fellesverkstedet/1810-CNC-Addons/Enclosure/Readme

This folder contains construction drawings for an enclosure, which can contain the 1810-CNC.
