fellesverkstedet/1810-CNC-Addons/Enclosure/README.md

# 1810-CNC-Addons
Parts for improving the small CNC milling machines at Fellesverkstedet
