fellesverkstedet/1810-CNC-Addons/HomingExtensions/X_Y_Axis_SensorHolder.step

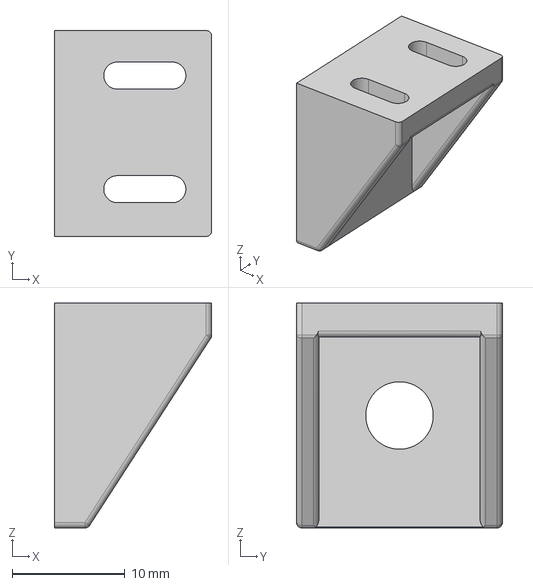
[picture p6: CAD file, 2019-10-28]
HomingExtensions/X_Y_Axis_SensorHolder.step
14.0 x 18.3 x 20.0 mm
