fellesverkstedet/1810-CNC-Addons/Maintenance/sacraficial-layer-for-1810-mill.dxf

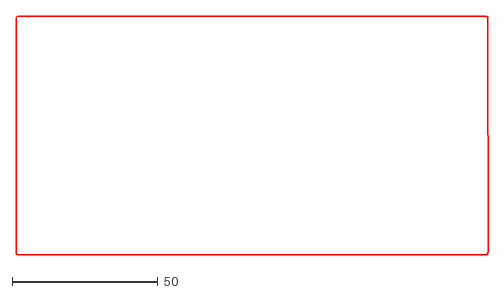
[picture p7: CAD file, 2021-08-19]
Maintenance/sacraficial-layer-for-1810-mill.dxf
162.0 x 82.0
