fellesverkstedet/1810-CNC-Addons/ControllerCase/ControllerCaseLower v11.step

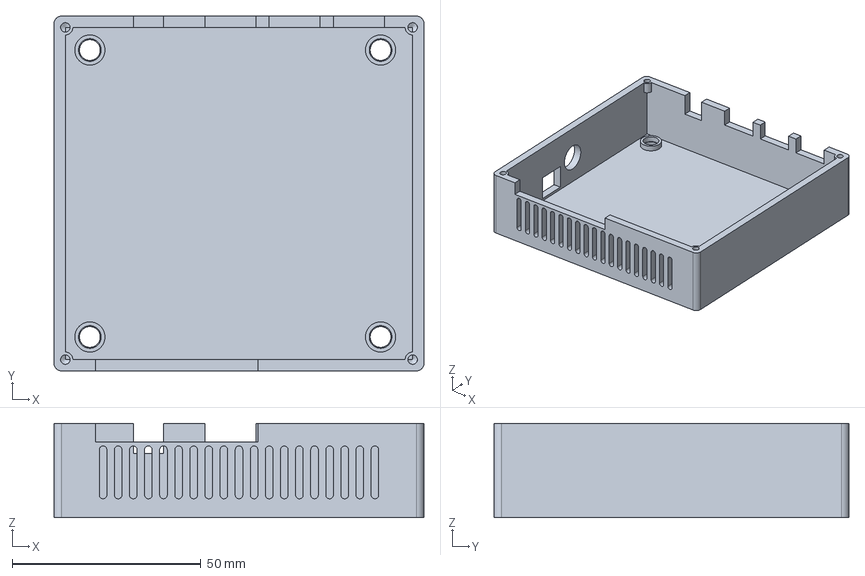
[picture p8: CAD file, 2019-10-28]
ControllerCase/ControllerCaseLower v11.step
98.0 x 94.0 x 25.0 mm
