fellesverkstedet/1810-CNC-Addons/HomingExtensions/X_Axis_SensorClipOn.step

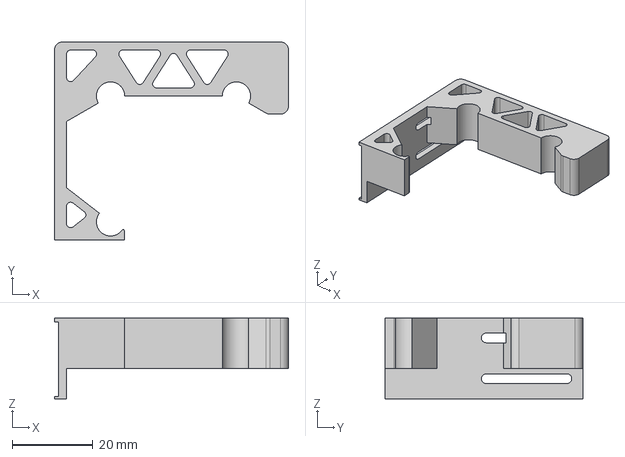
[picture p10: CAD file, 2019-10-28]
HomingExtensions/X_Axis_SensorClipOn.step
58.0 x 49.1 x 20.0 mm
