fellesverkstedet/1810-CNC-Addons/ControllerCase/CaseLid v4.step

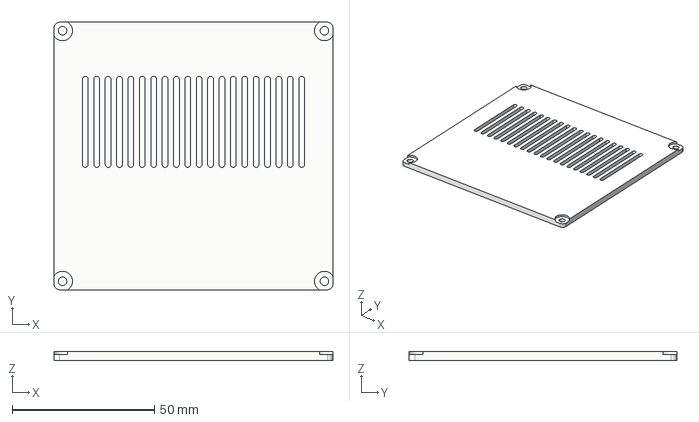
[picture p11: CAD file, 2019-10-28]
ControllerCase/CaseLid v4.step
98.0 x 94.0 x 3.00 mm
