fellesverkstedet/1810-CNC-Addons/Enclosure/Sides v5.step

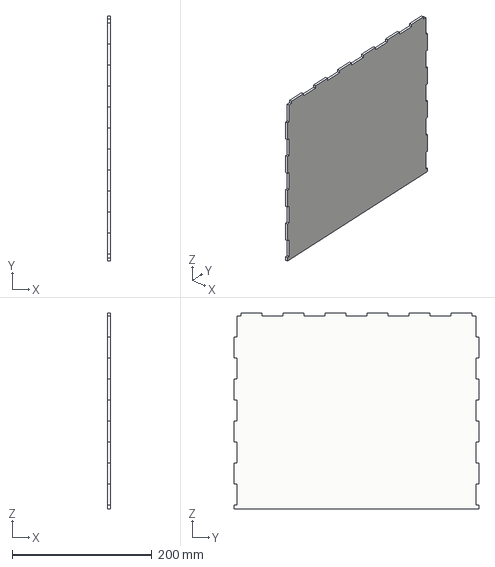
[picture p12: CAD file, 2019-10-28]
Enclosure/Sides v5.step
4.00 x 350.0 x 280.0 mm
