fellesverkstedet/1810-CNC-Addons/ControllerCase/CaseLid Drawing v1 Sheet1.dxf

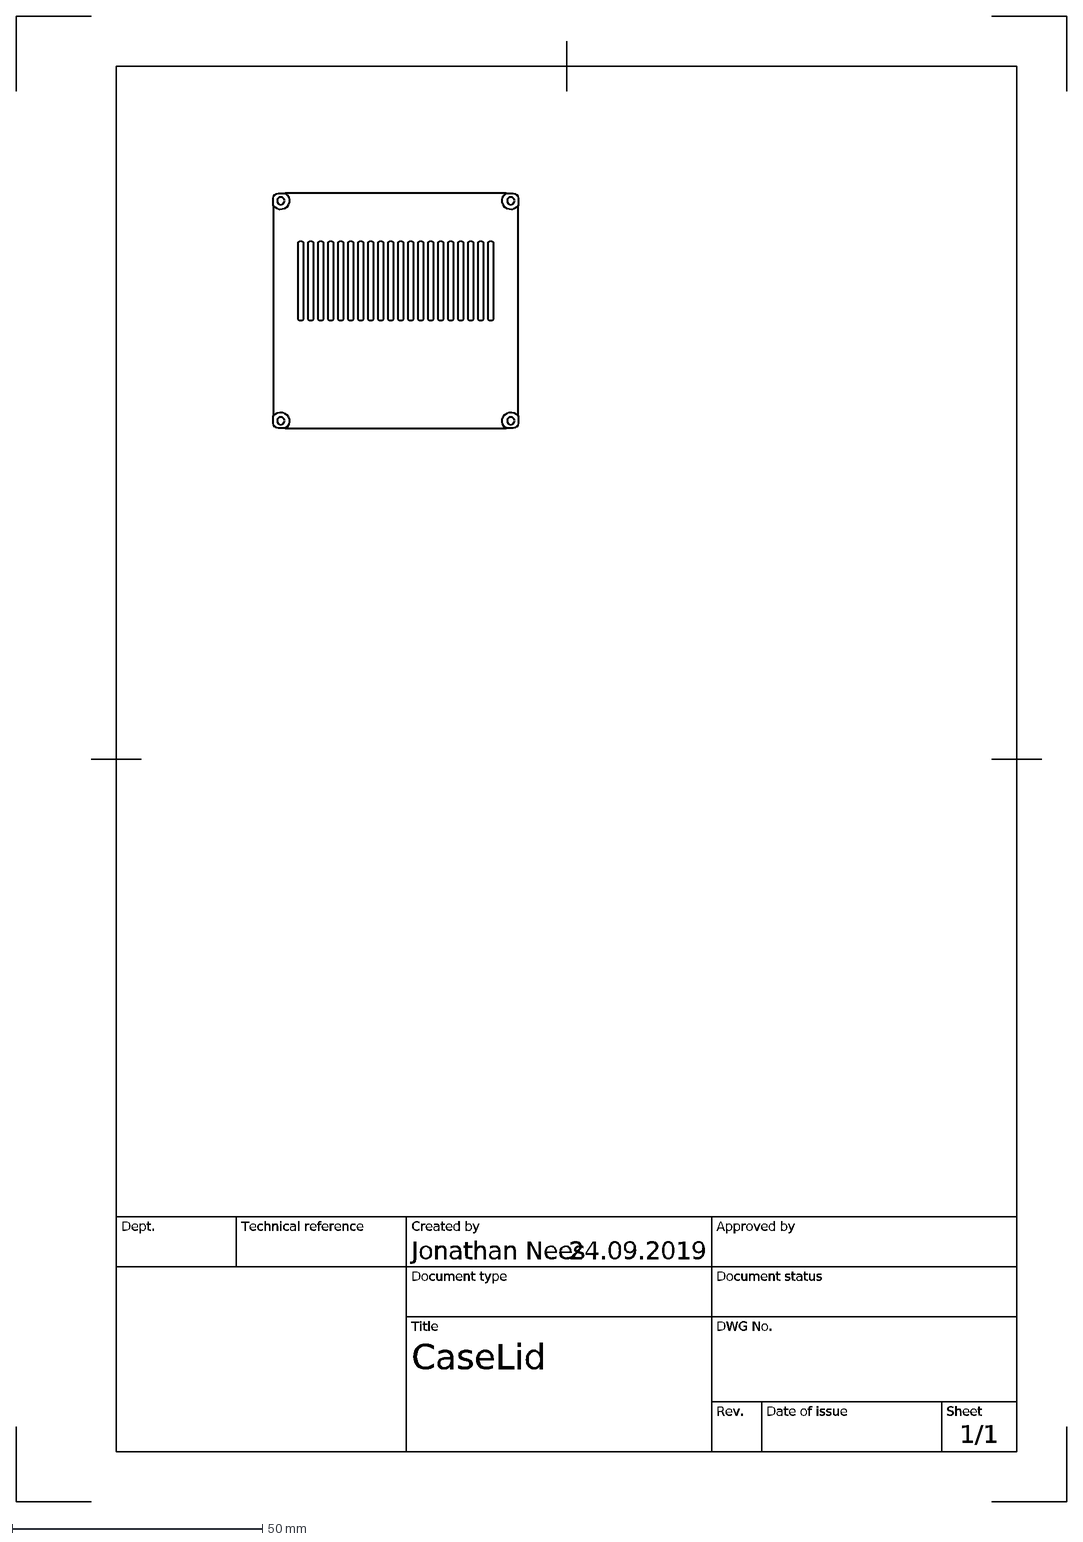
[picture p13: CAD file, 2019-10-28]
ControllerCase/CaseLid Drawing v1 Sheet1.dxf
24.09.2019
1/1
CaseLid
Jonathan Nees
Dept.
Technical reference
Created by
Approved by
Document type
Document status
Title
DWG No.
Rev.
Date of issue
Sheet
