fellesverkstedet/1810-CNC-Addons/Enclosure/UtilitiesLock.dxf

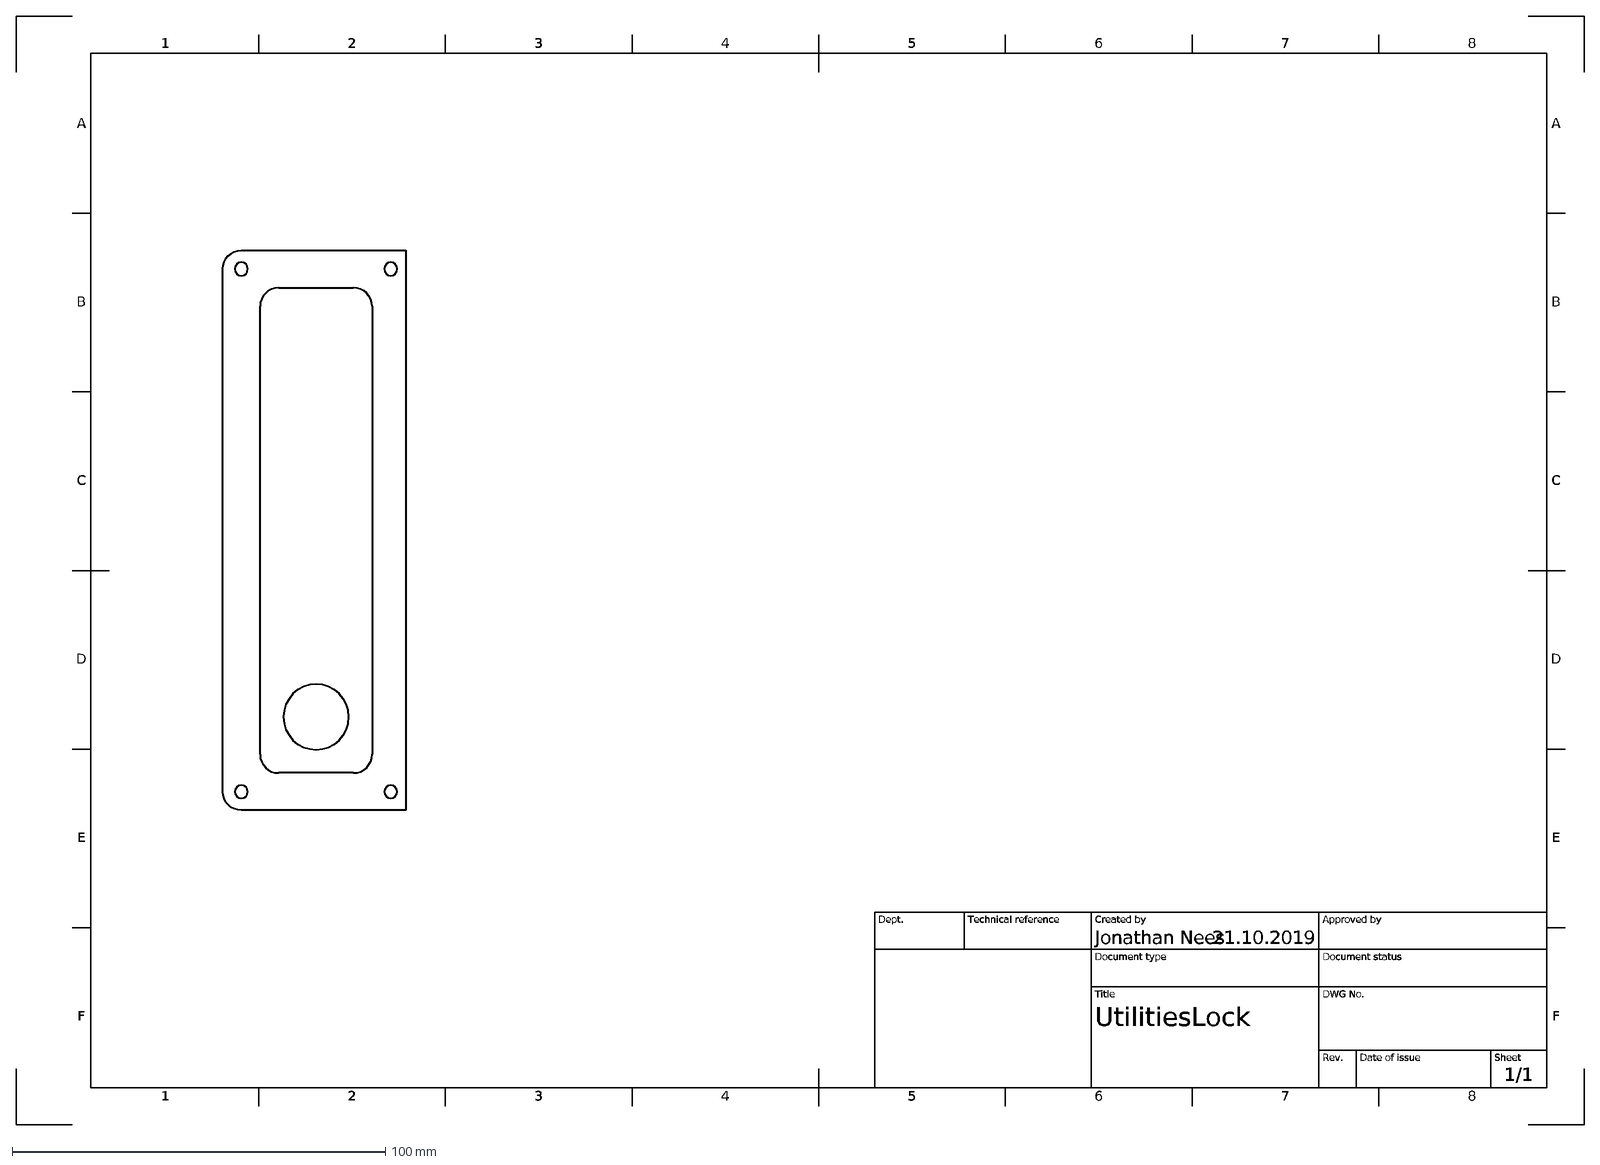
[picture p15: CAD file, 2019-10-28]
Enclosure/UtilitiesLock.dxf
1
A
2
3
4
5
6
7
8
B
C
D
E
F
21.10.2019
1/1
UtilitiesLock
Jonathan Nees
Dept.
Technical reference
Created by
Approved by
Document type
Document status
Title
DWG No.
Rev.
Date of issue
Sheet
