fellesverkstedet/1810-CNC-Addons/Enclosure/TopPlate v10.step

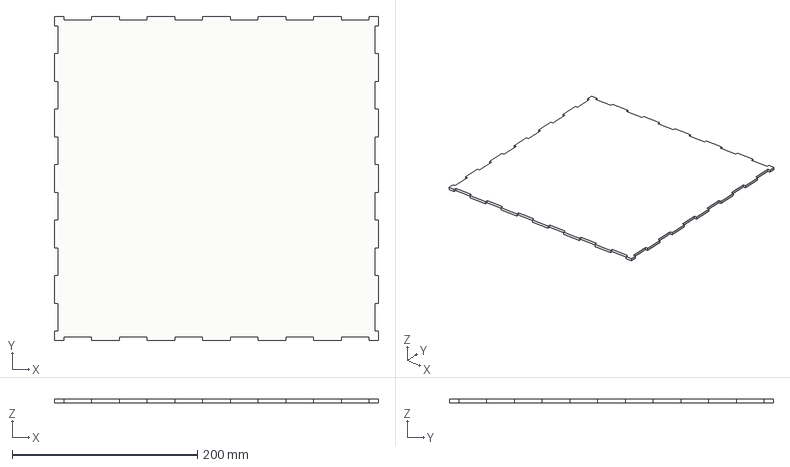
[picture p16: CAD file, 2019-10-28]
Enclosure/TopPlate v10.step
350.0 x 350.0 x 4.00 mm
