fellesverkstedet/1810-CNC-Addons/Enclosure/EnclosureBase_01 v13.step

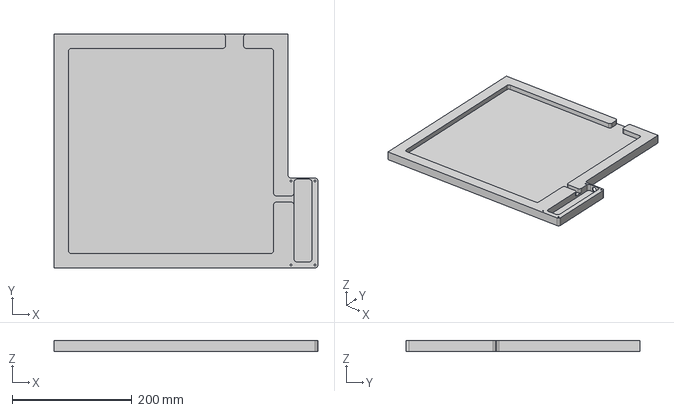
[picture p17: CAD file, 2019-10-28]
Enclosure/EnclosureBase_01 v13.step
440.0 x 390.0 x 18.0 mm
