fellesverkstedet/1810-CNC-Addons/HomingExtensions/Z_Axis_ScrewHolder.step

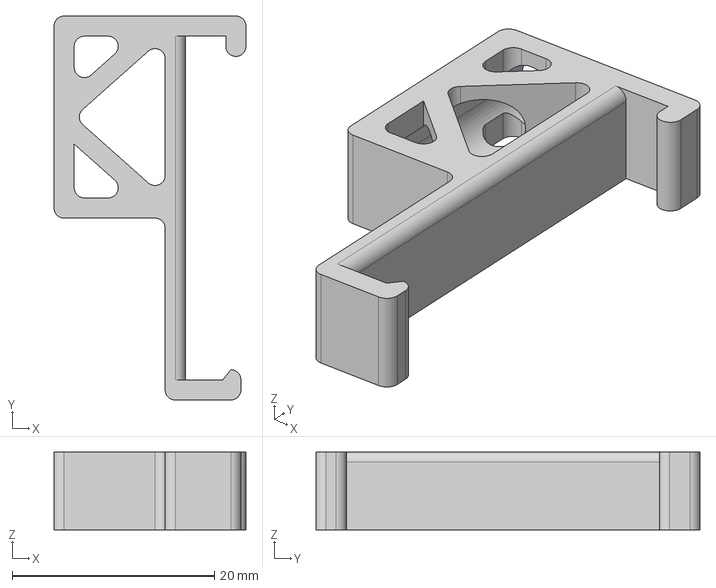
[picture p20: CAD file, 2019-10-28]
HomingExtensions/Z_Axis_ScrewHolder.step
19.0 x 38.0 x 7.70 mm
