fellesverkstedet/1810-CNC-Addons/(list of files, cad)

Other CAD files:
ControllerCase/CaseLid Drawing v1.dwg
HomingExtensions/Z_Axis_SensorClipOn.stl
ControllerCase/CaseLid v4.f3d
ControllerCase/ControllerCaseLower v11.stl
ControllerCase/ControllerCaseLower.f3d
Enclosure/Sides v5.f3d
Enclosure/TopPlate v10.f3d
HomingExtensions/X_Y_Axis_SensorHolder.f3d
HomingExtensions/X_Y_Axis_SensorHolder.stl
HomingExtensions/Z_Axis_ScrewHolder.stl
HomingExtensions/Z_Axis_SensorClipOn.f3d
HomingExtensions/y_Axis_ScreHolder.f3d
Maintenance/sacraficial-layer-for-1810-mill.3dm
Maintenance/sacrificial-layer-milling.3dm
