fellesverkstedet/1810-CNC-Addons/Assembly instructions/CNC3-1610Pro.docx

# CNC3-1610Pro

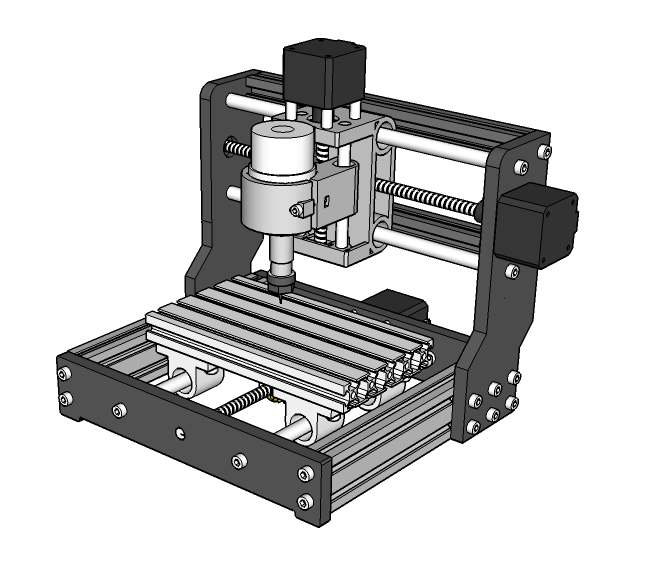
[picture p28: figure]

Bakelite：

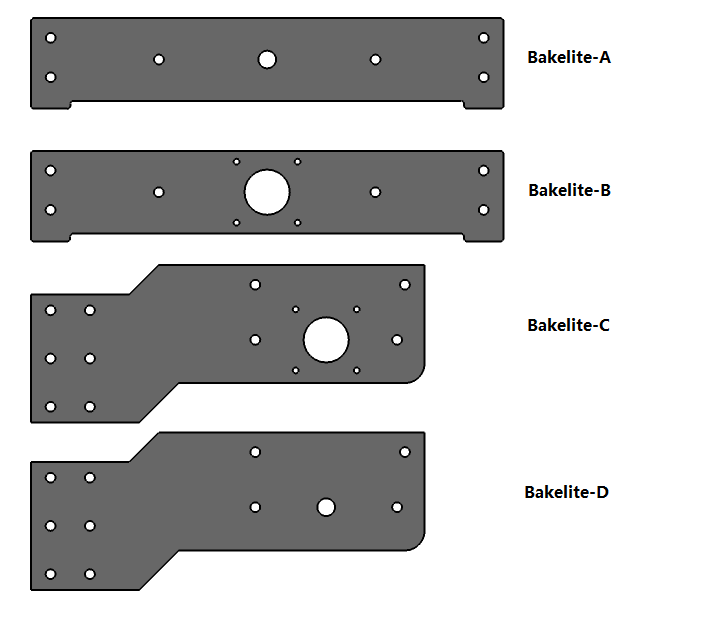
[picture p29: figure]

Tool：

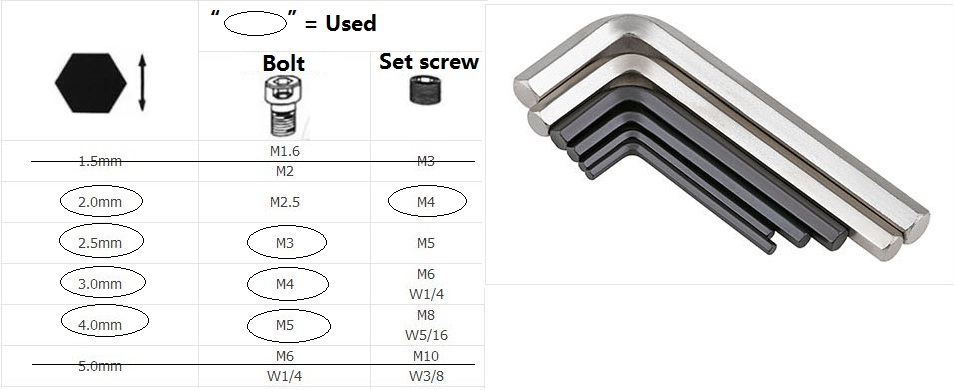
[picture p30: figure]

# STEP1. Base Assemble

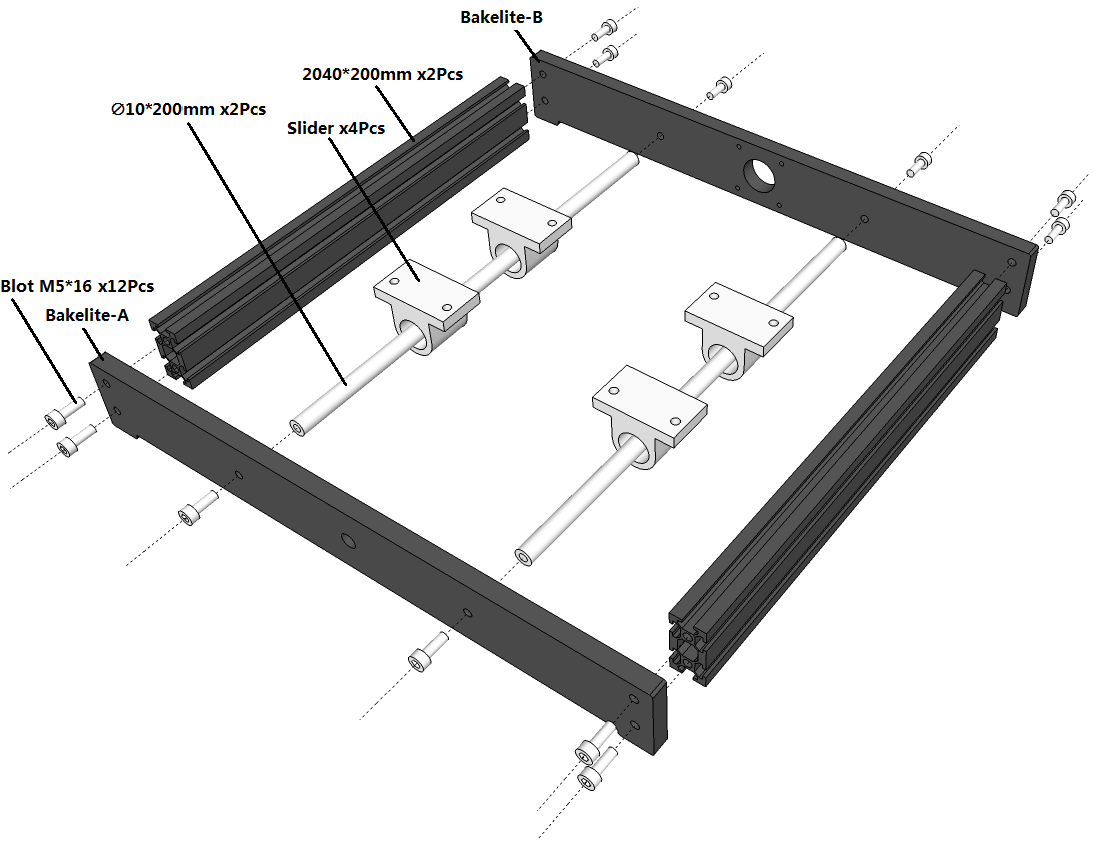
[picture p31: figure]

Step2. Table Assemble

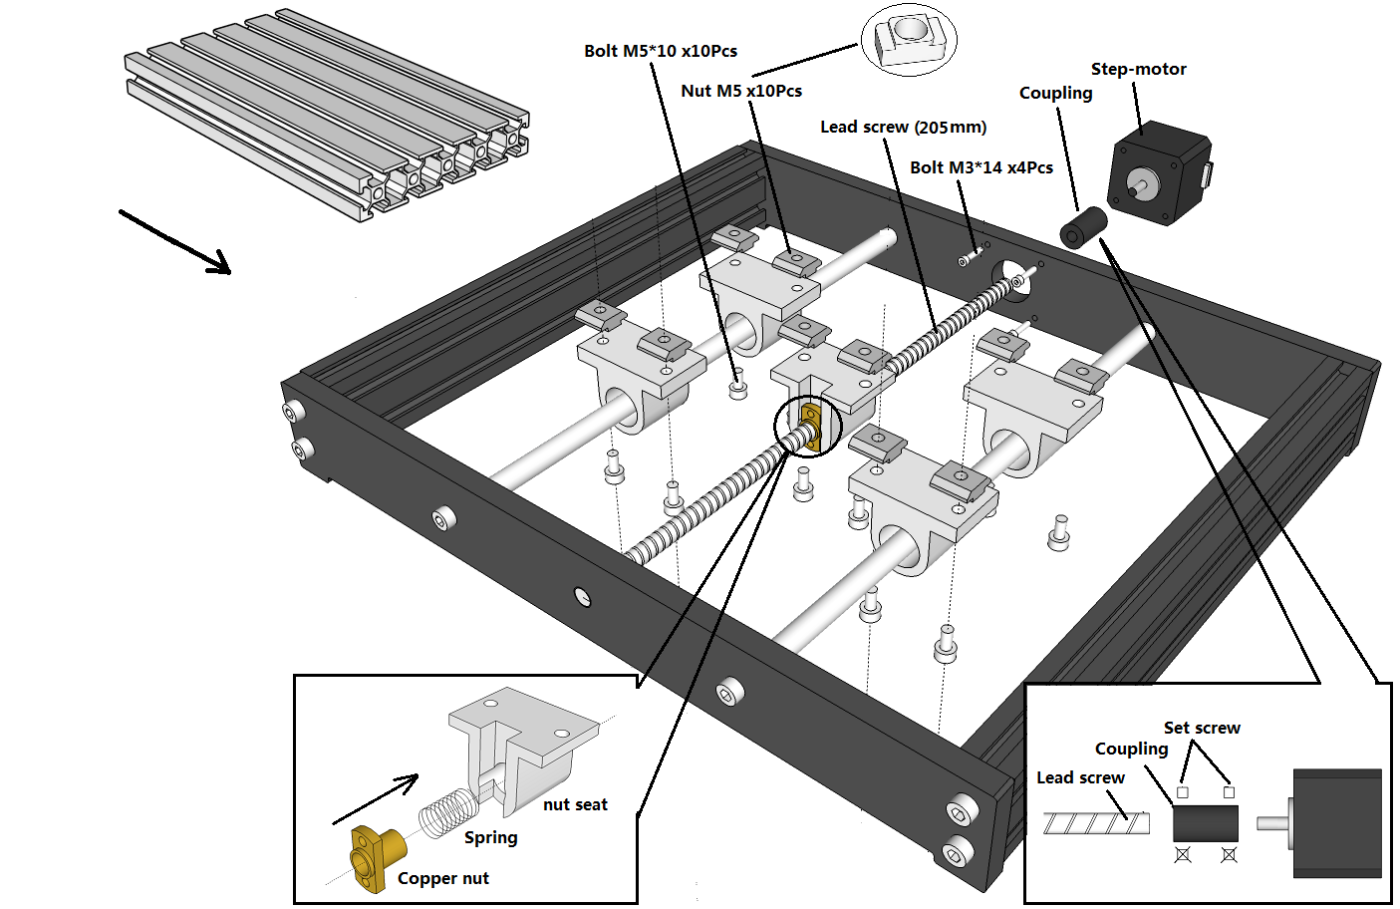
[picture p32: figure]

Completed:

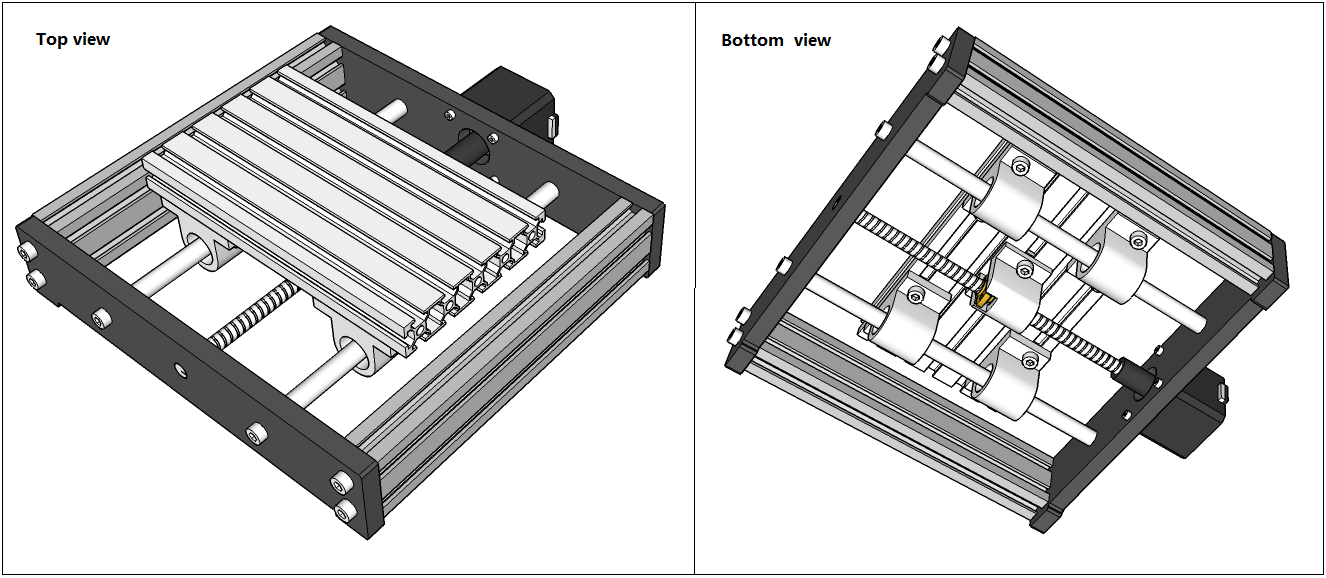
[picture p33: figure]

Step3. Base & Bakelite-C

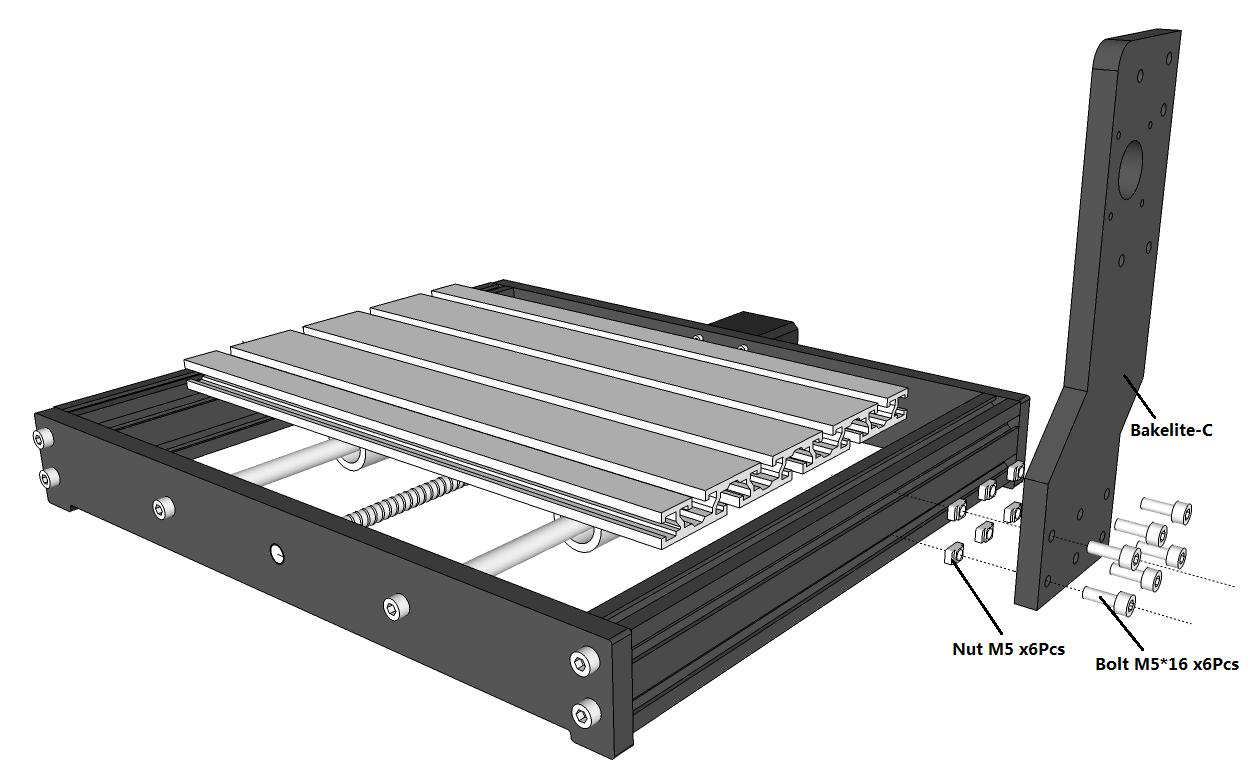
[picture p34: figure]

Completed & Ubiety:

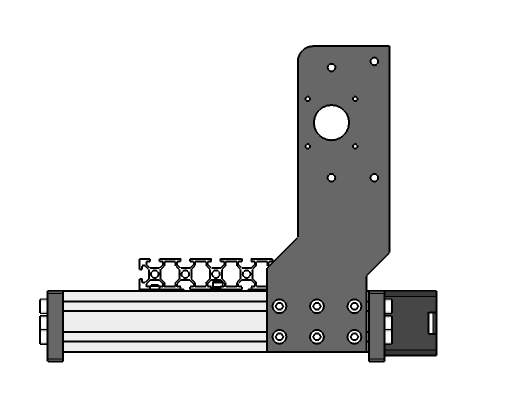
[picture p35: figure]

Step4. X-Zaxis

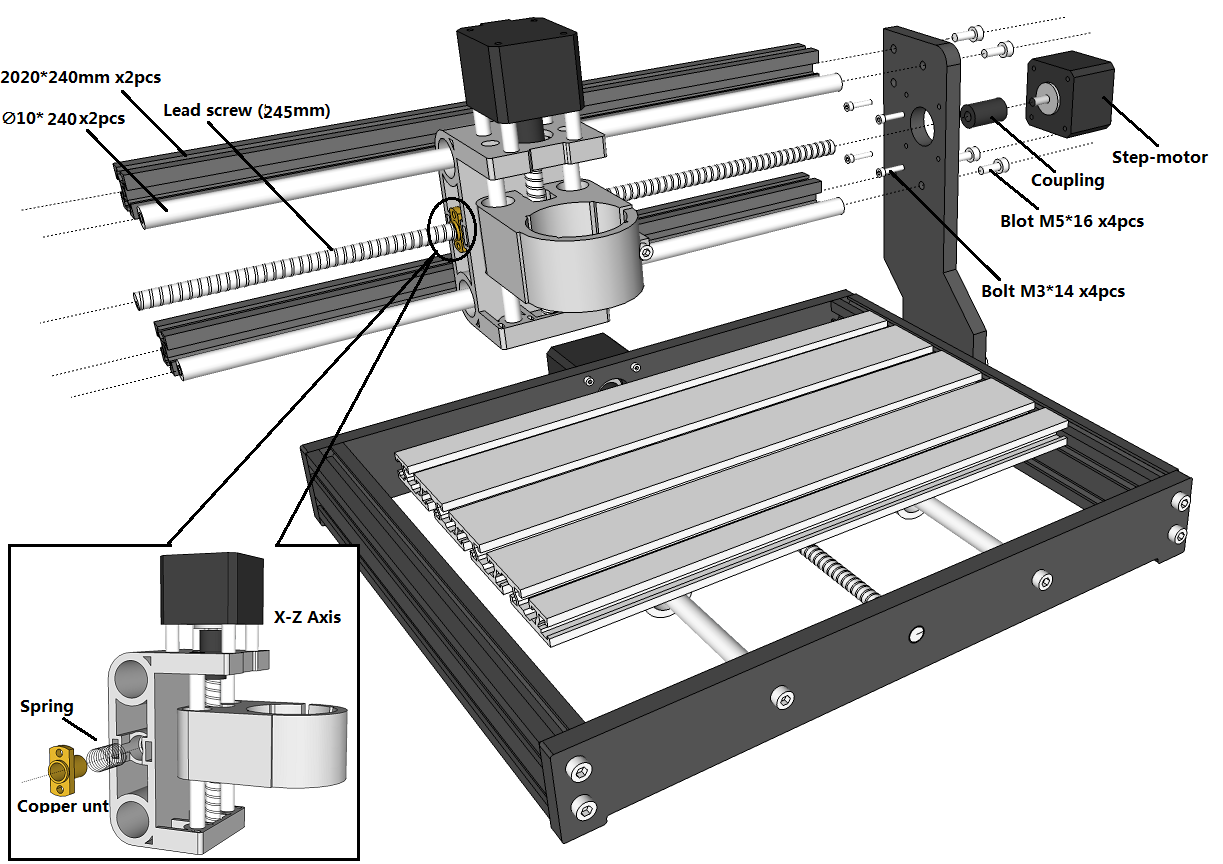
[picture p36: figure]

Step5. Bakelite-D

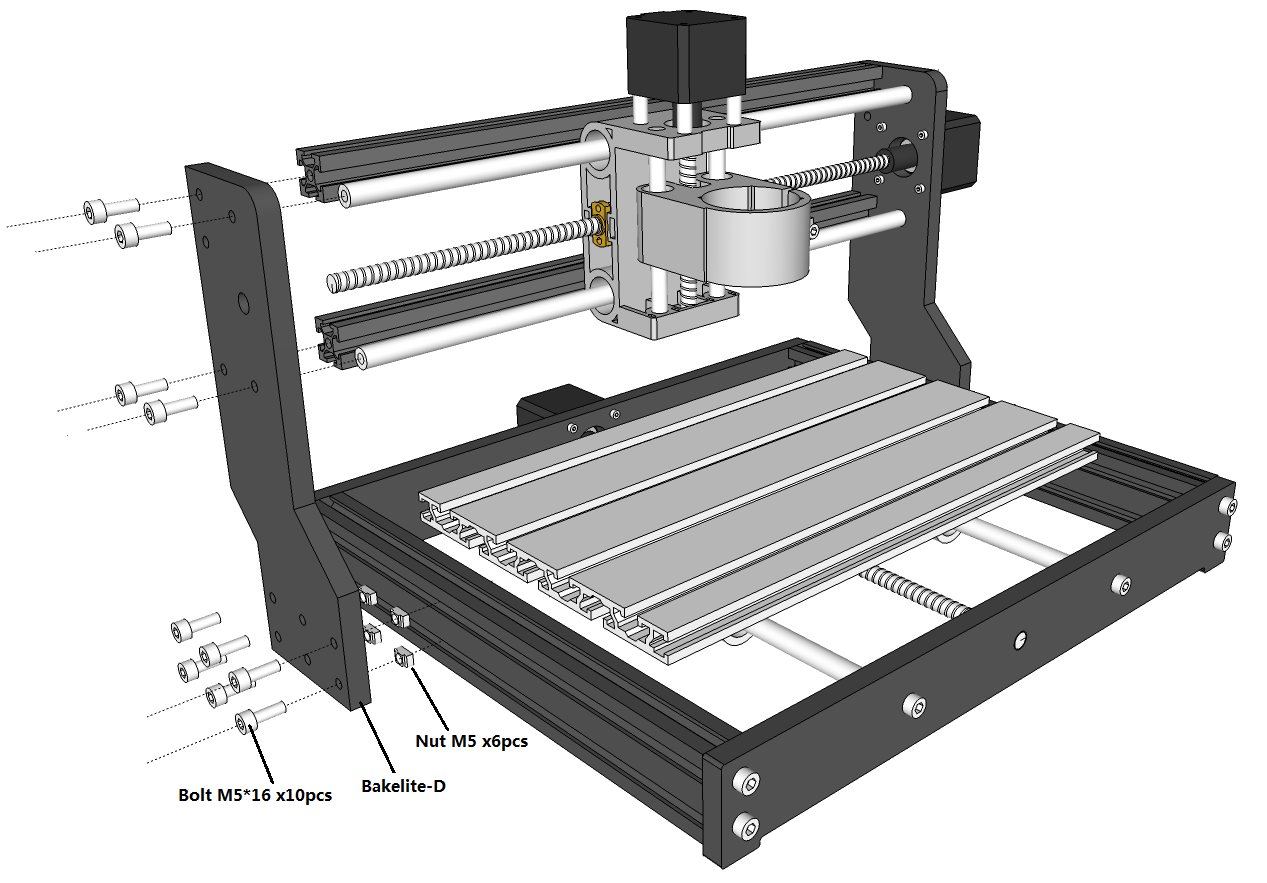
[picture p37: figure]

Completed & Ubiety:

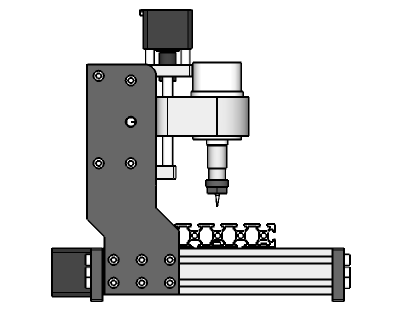
[picture p38: figure]

Step6. Sipndle

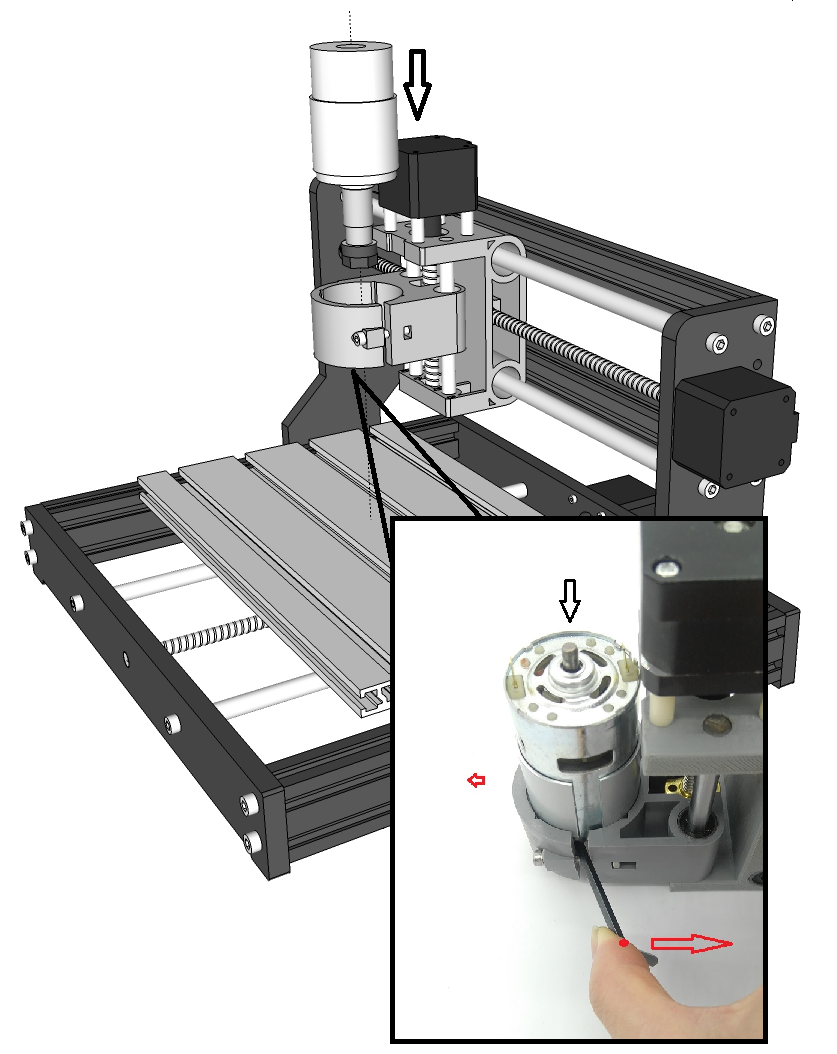
[picture p39: figure]
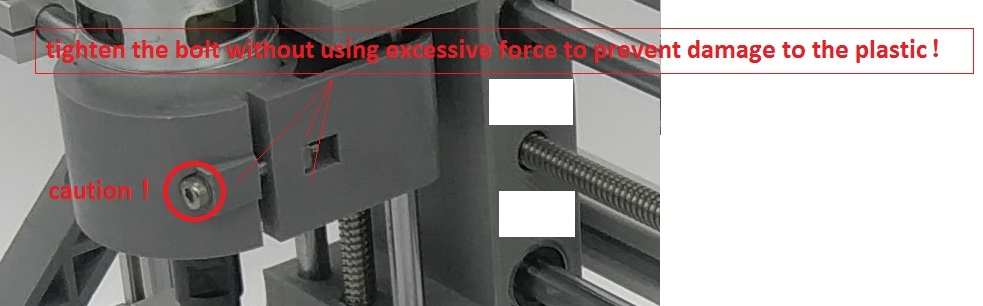
[picture p40: figure]

Step7. Control board

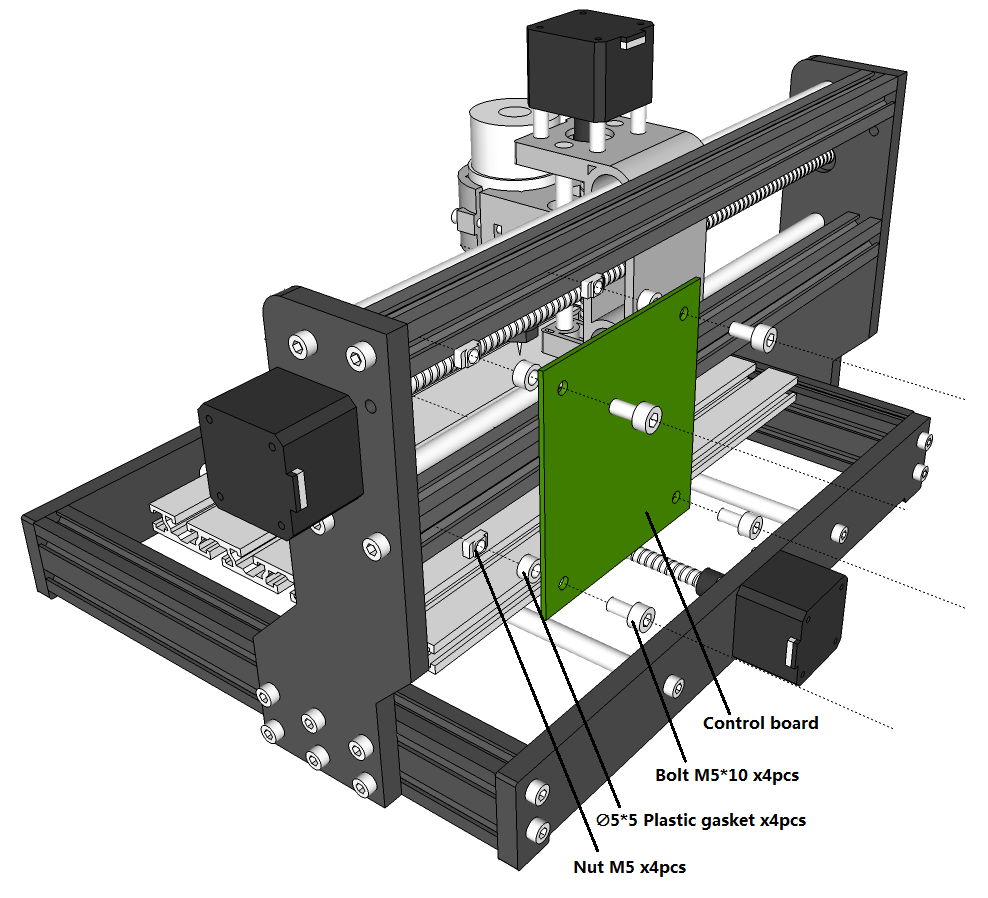
[picture p41: figure]

Step8. Wiring diagrams

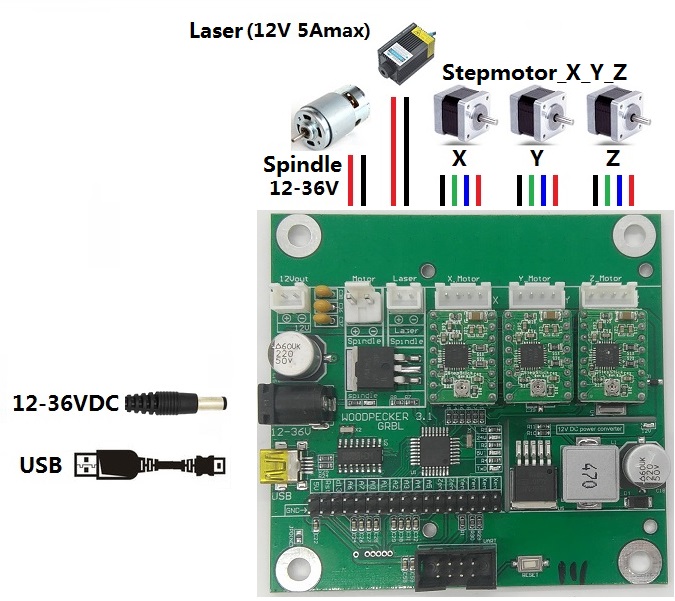
[picture p42: figure]
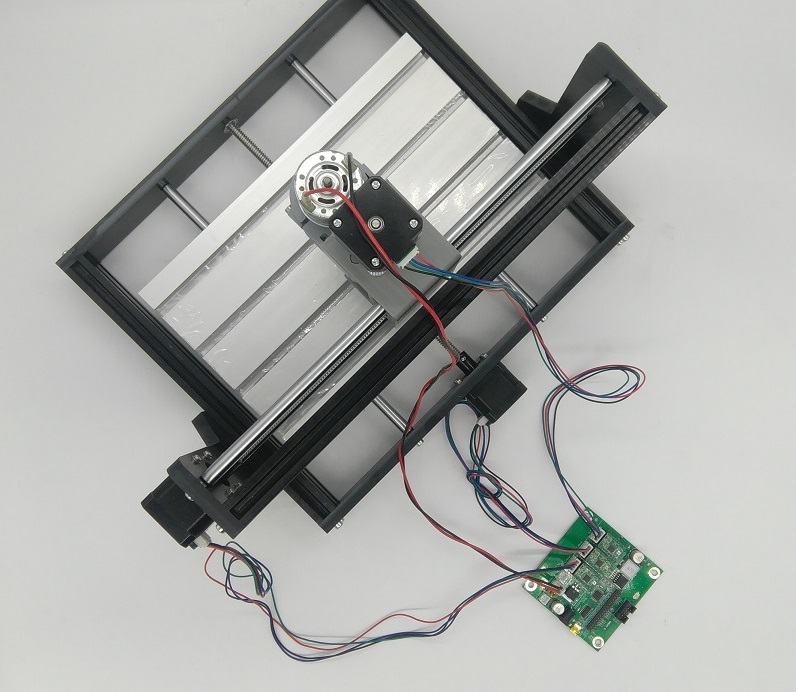
[picture p43: figure]
