fellesverkstedet/1810-CNC-Addons/Assembly instructions/5.5W_laser_connection.jpg

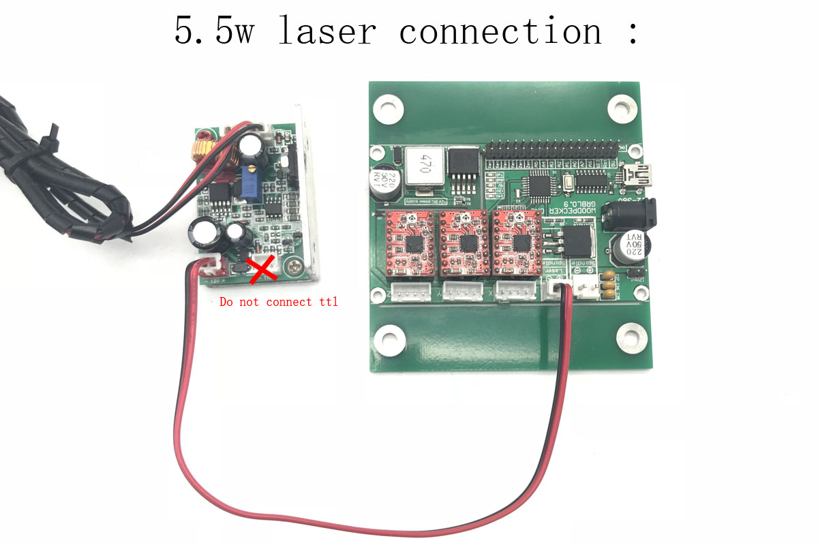
Assembly instructions/5.5W_laser_connection.jpg
