fellesverkstedet/1810-CNC-Addons/(commit log)

2019-10-28 Move Files
    [EnclosureBase_01 v13.step, Front.dxf, Margin_Puzzle.dxf, Sides v5.f3d, Sides v5.step, Sides.dxf, TopPlate v10.f3d, TopPlate v10.step]
2019-10-28 Further Documentation, Controller Case...
    [CaseLid Drawing v1 Sheet1.dxf, CaseLid Drawing v1.dwg, CaseLid v4.f3d, CaseLid v4.step, ControllerCaseLower v11.step, ControllerCaseLower v11.stl, ControllerCaseLower.f3d, X_Axis_SensorClipOn.step]
2021-08-16 made backup of factory grbl firmware
2021-08-18 updated docu
    [sacrificial-layer-milling.3dm]
2021-08-19 added images and sacrificial layer
    [sacraficial-layer-for-1810-mill.3dm, sacraficial-layer-for-1810-mill.dxf, sacrificial-layer-milling.3dm]
